sionetta/step_pendulum/Schematic/esp32-c3-super-mini-pinouts.jpg

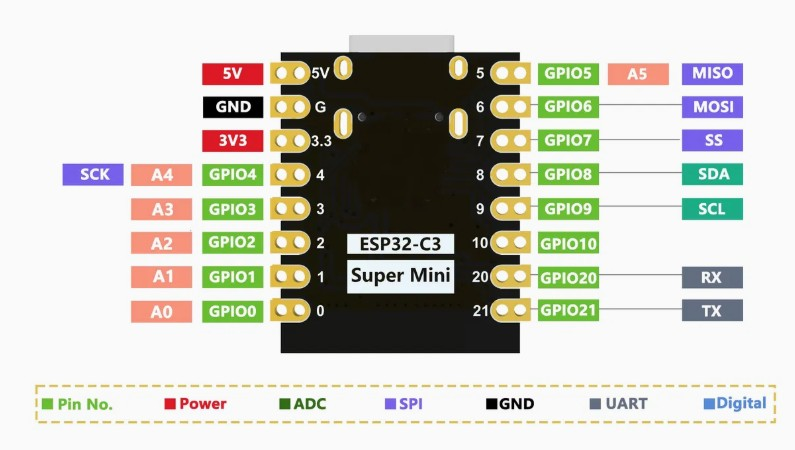
Schematic/esp32-c3-super-mini-pinouts.jpg
