sionetta/step_pendulum/3D/Clamp/pad.stl

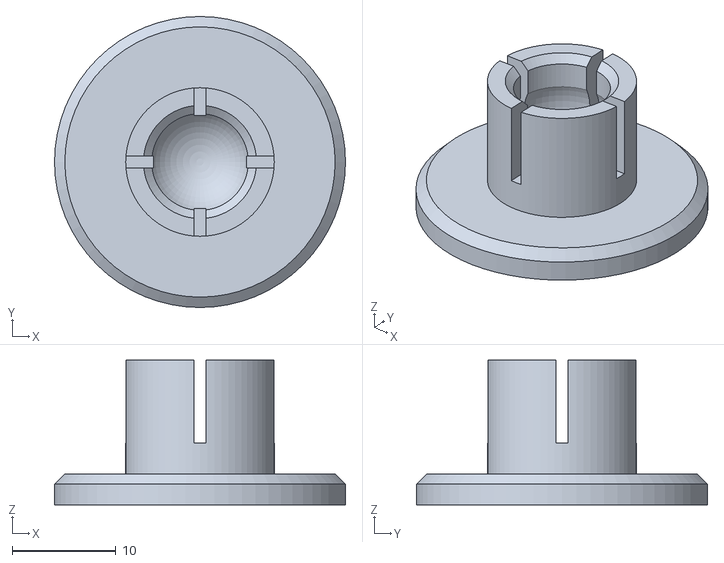
[picture p4: CAD file, 2026-11-05]
3D/Clamp/pad.stl
28.0 x 28.0 x 13.9
