sionetta/step_pendulum/3D/Cradle/knob.stl

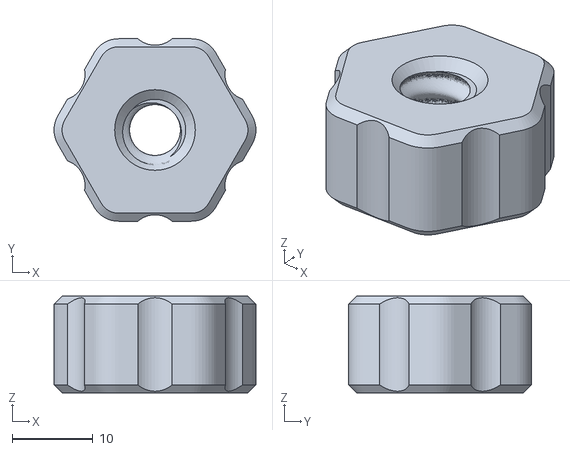
[picture p5: CAD file, 2026-11-05]
3D/Cradle/knob.stl
25.0 x 22.6 x 12.0
