sionetta/step_pendulum/3D/Clamp/body_v4.stl

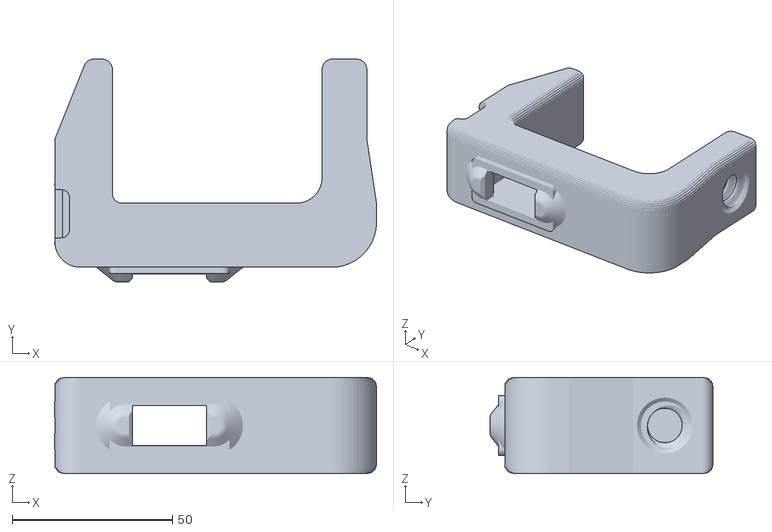
[picture p6: CAD file, 2026-11-05]
3D/Clamp/body_v4.stl
100.6 x 69.6 x 30.0
