sionetta/step_pendulum/3D/Cradle/cradle.stl

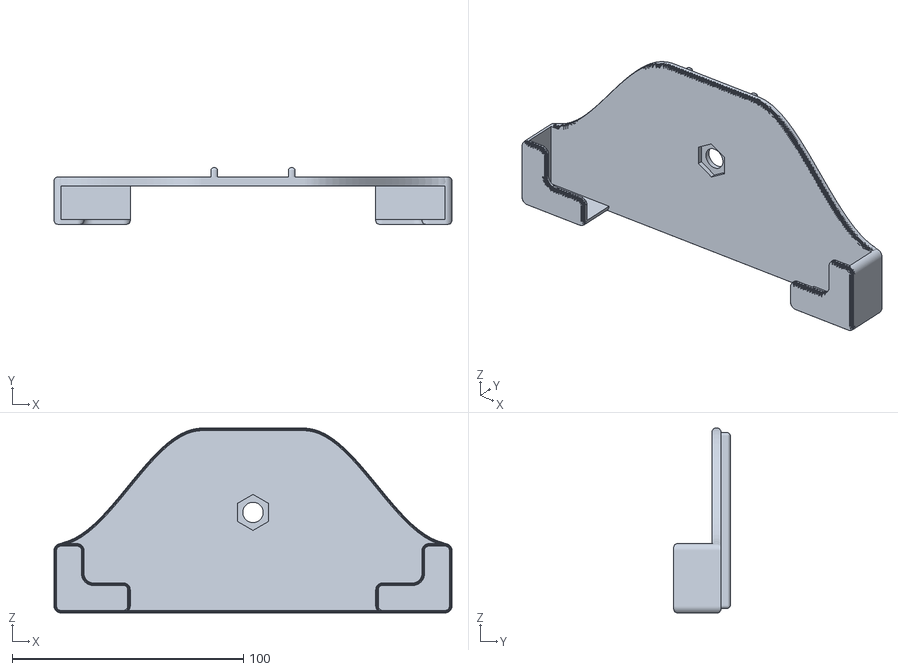
[picture p7: CAD file, 2026-11-05]
3D/Cradle/cradle.stl
172.2 x 24.5 x 80.0
