sionetta/step_pendulum/3D/Cradle/bolt.stl

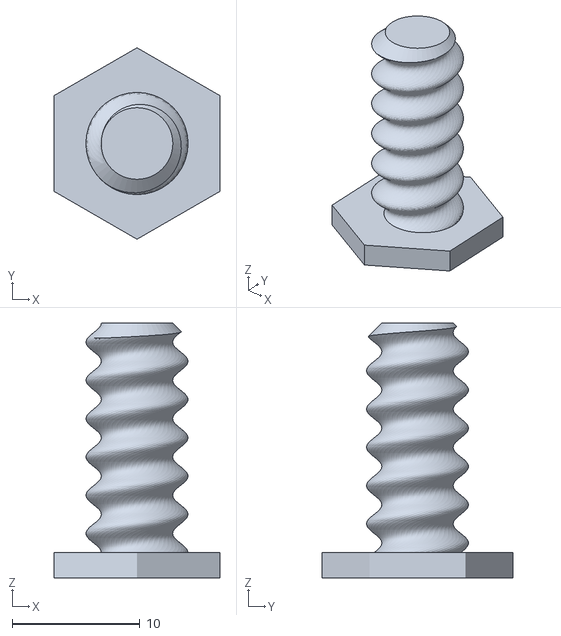
[picture p8: CAD file, 2026-11-05]
3D/Cradle/bolt.stl
13.0 x 15.0 x 20.0
