sionetta/step_pendulum/3D/Clamp/screw.stl

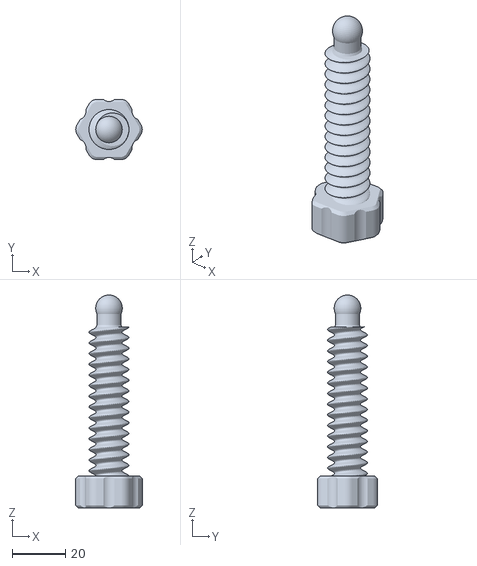
[picture p9: CAD file, 2026-11-05]
3D/Clamp/screw.stl
25.0 x 22.6 x 80.0
