sionetta/step_pendulum/(commit log)

2026-11-05 Первая публикация проекта
    [body_v4.stl, bolt.stl, cradle.stl, knob.stl, pad.stl, pendulum_clamp_v4.scad, pendulum_cradle.scad, screw.stl]
2026-11-05 README по текущей ревизии, сенсор шагов в substitutions
2026-11-05 Новая схема подключения, уточнения по кнопке и конденсатору
